lucaslealdev/sicksnes/(commit log)

2025-03-16 Fix wording in README.md regarding Arduino initialization for Street Fighter Alpha 2
2025-03-18 Blink led when cic is turned off
2025-03-18 allows using only one led
2025-04-07 add led feedback for reset combo
2025-04-07 add branch filter for main in build and release workflow
2025-04-10 Add wiring diagram for stock RGB LED to README
2025-04-21 feat: implement EEPROM storage for button combos and factory reset functionality
2025-04-21 feat: separate implementation for LED, CIC, reset, and controller functionalities
2025-04-22 feat: add LED control functions and improve CIC handling logic
2025-05-18 feat: add green and red ground pin definitions to control led using ground
2025-05-31 docs: add sample installation images to README
